valentinval90/Poolconnect/circuit_image.png

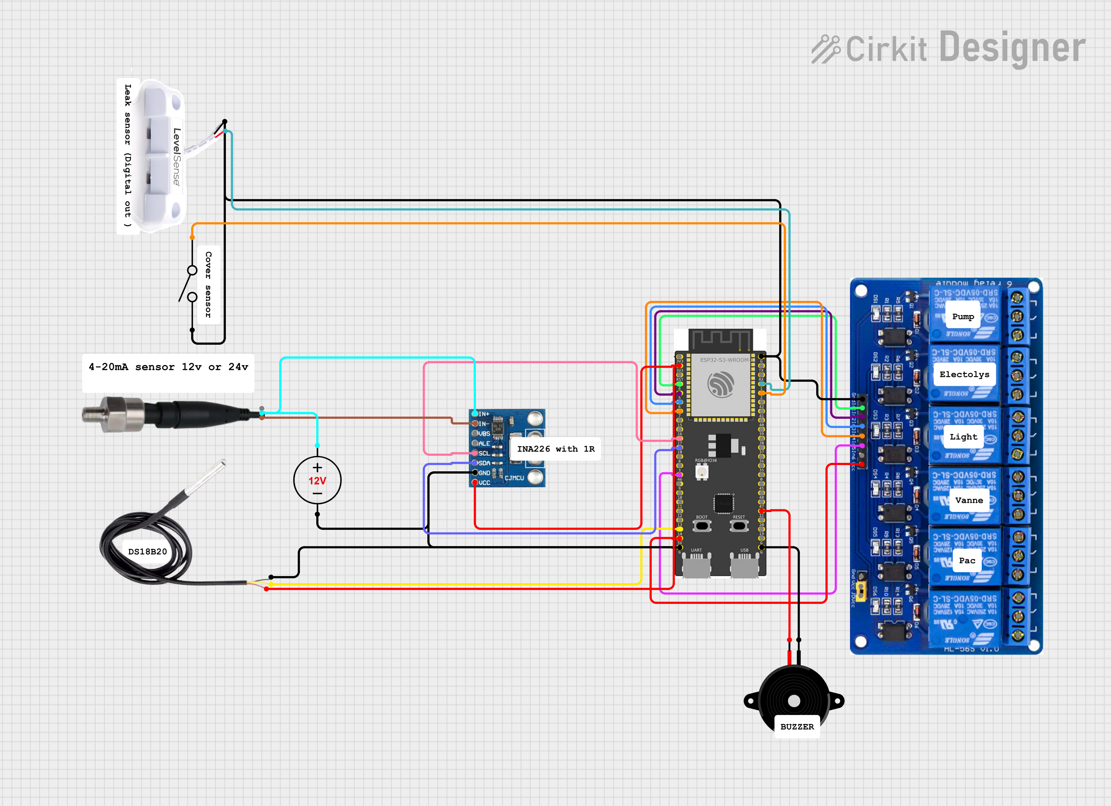
circuit_image.png
