valentinval90/Poolconnect/img/Assistant_Etalonnage.png

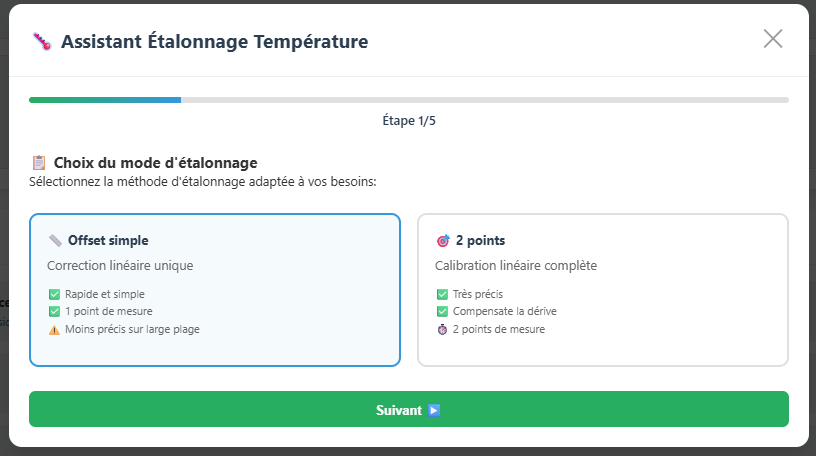
img/Assistant_Etalonnage.png
