valentinval90/Poolconnect/img/Assistant_Etalonnage_valid.png

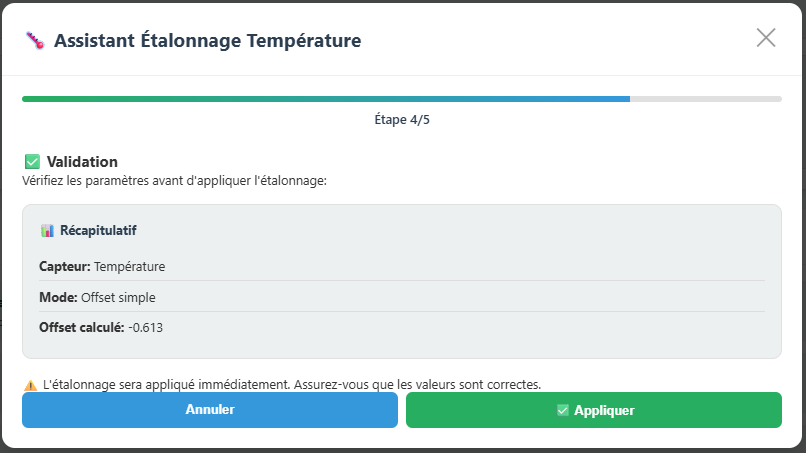
img/Assistant_Etalonnage_valid.png
