valentinval90/Poolconnect/img/Controle.png

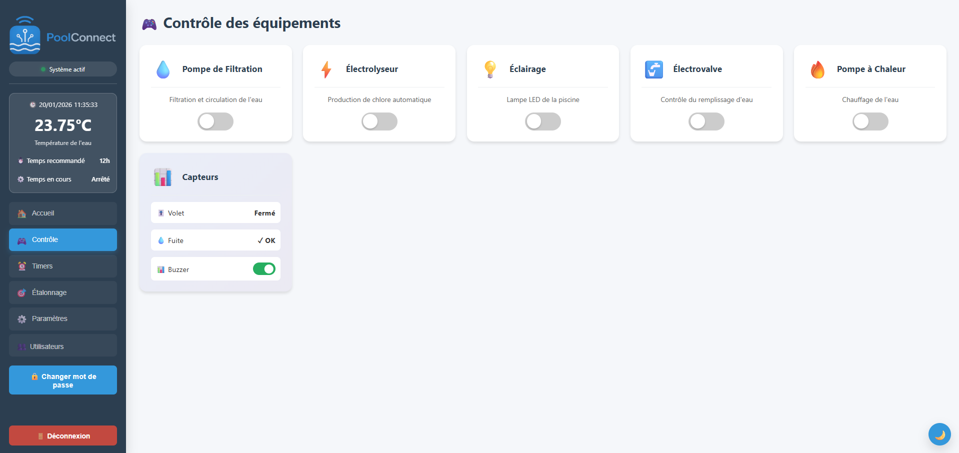
img/Controle.png
