valentinval90/Poolconnect/img/Etalonnage.png

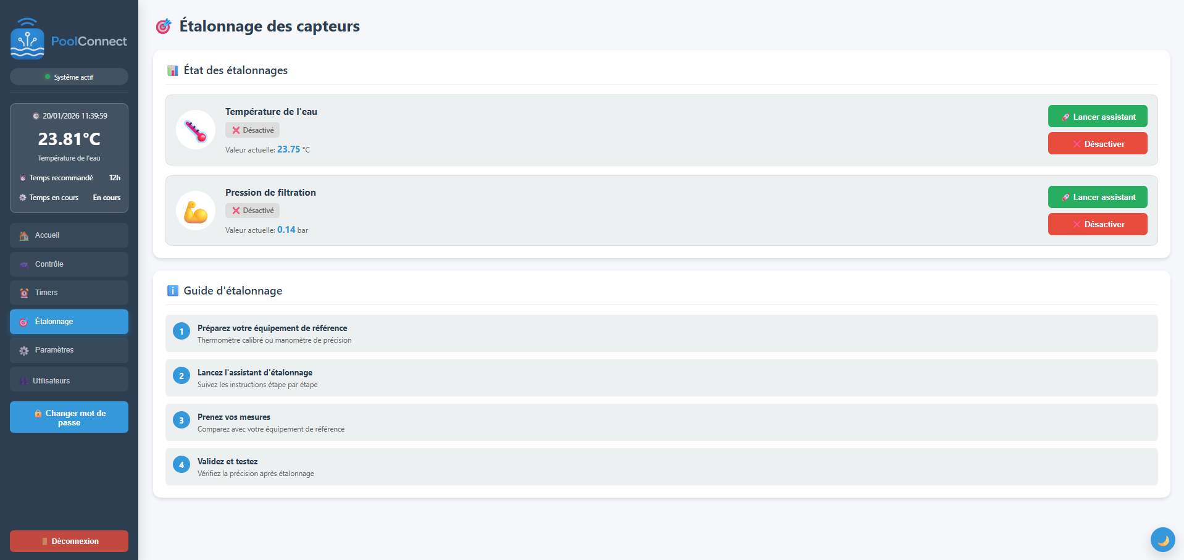
img/Etalonnage.png
