valentinval90/Poolconnect/img/Nouveau_timmer_action.png

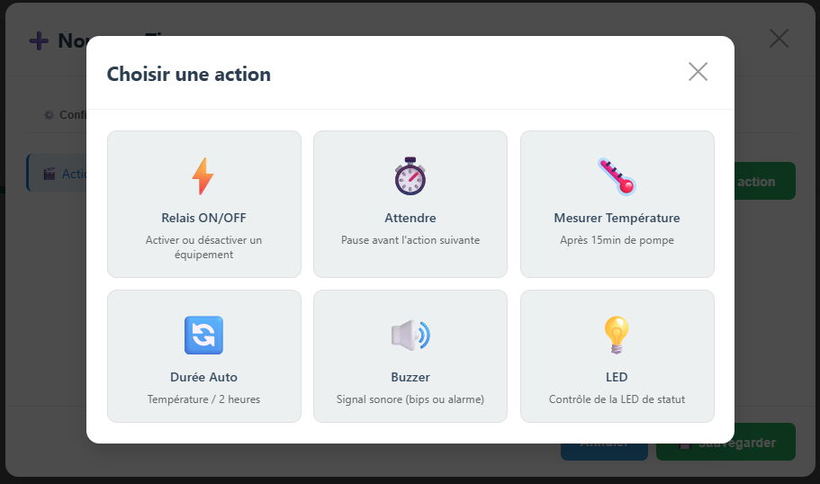
img/Nouveau_timmer_action.png
