valentinval90/Poolconnect/img/Nouveau_timmer_Aperçus.png

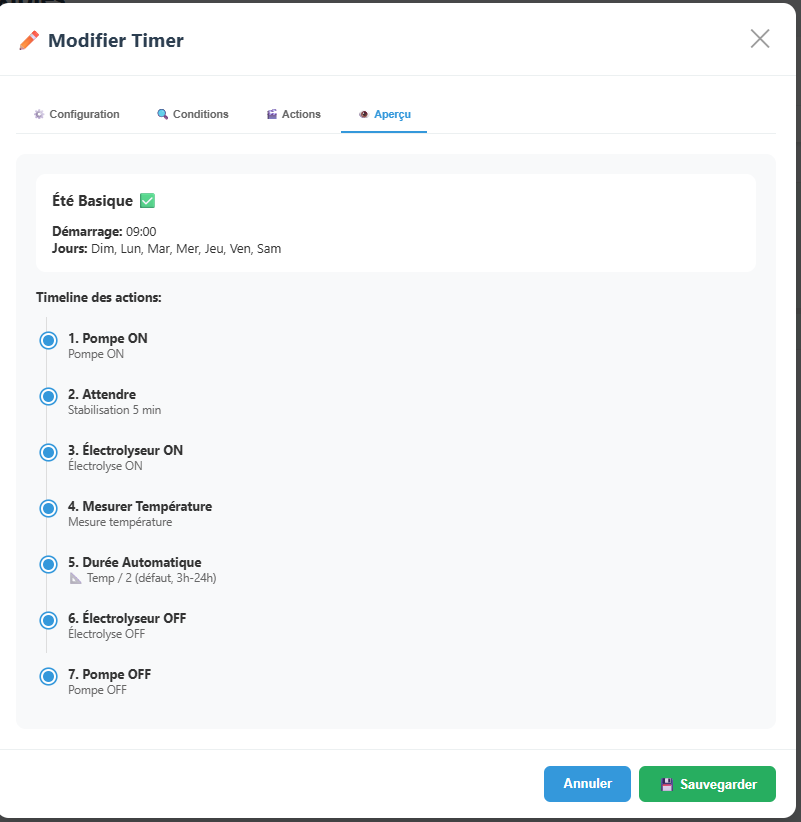
img/Nouveau_timmer_Aperçus.png
