valentinval90/Poolconnect/img/Nouveau_timmer_Condition.png

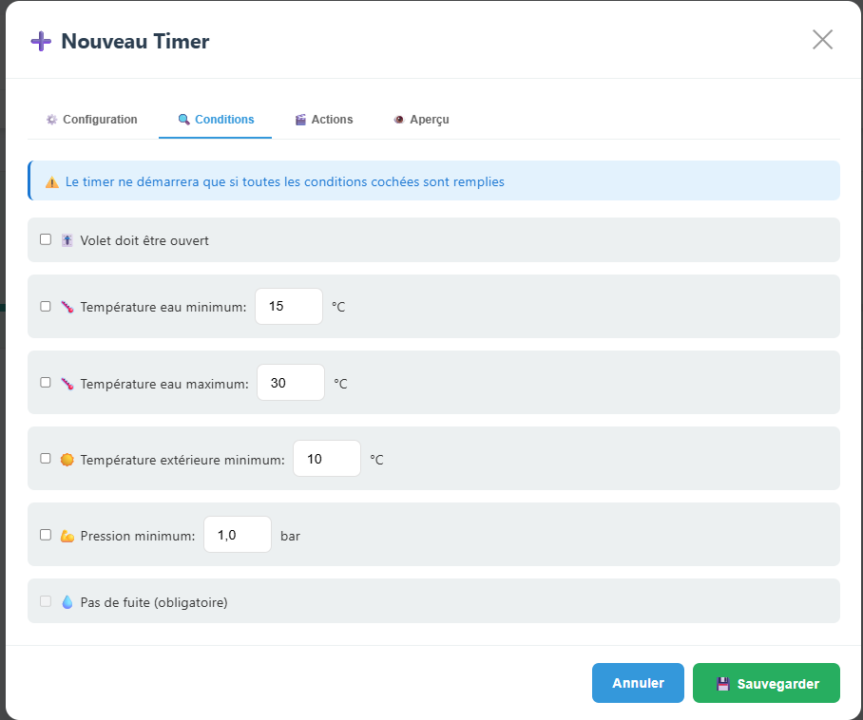
img/Nouveau_timmer_Condition.png
