valentinval90/Poolconnect/img/Nouveau_timmer_config.png

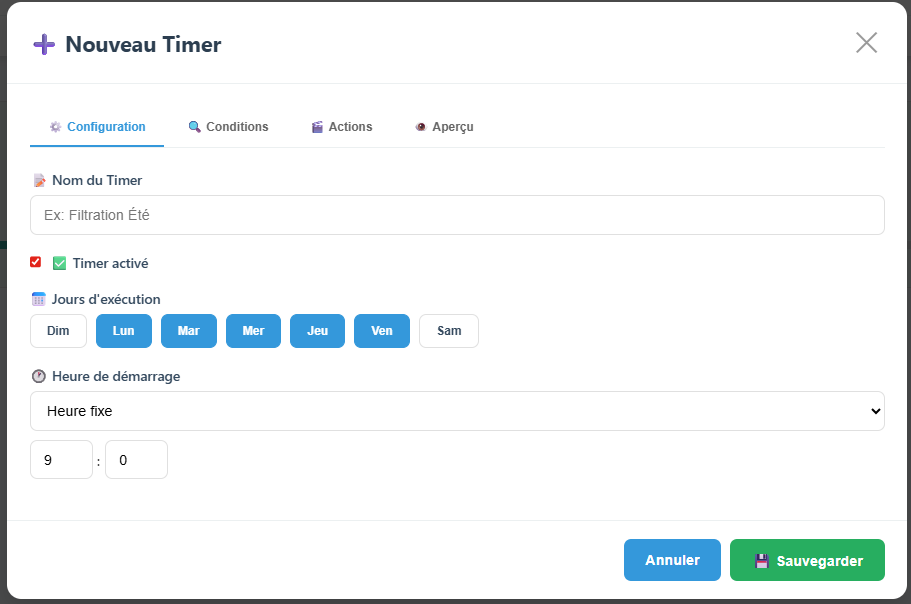
img/Nouveau_timmer_config.png
