valentinval90/Poolconnect/img/Parametres_BAS.png

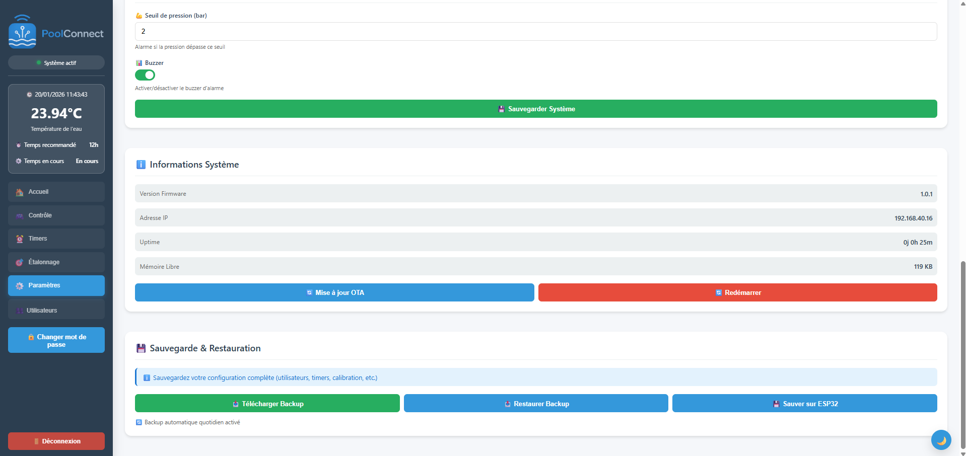
img/Parametres_BAS.png
