valentinval90/Poolconnect/img/Parametres_HAUT.png

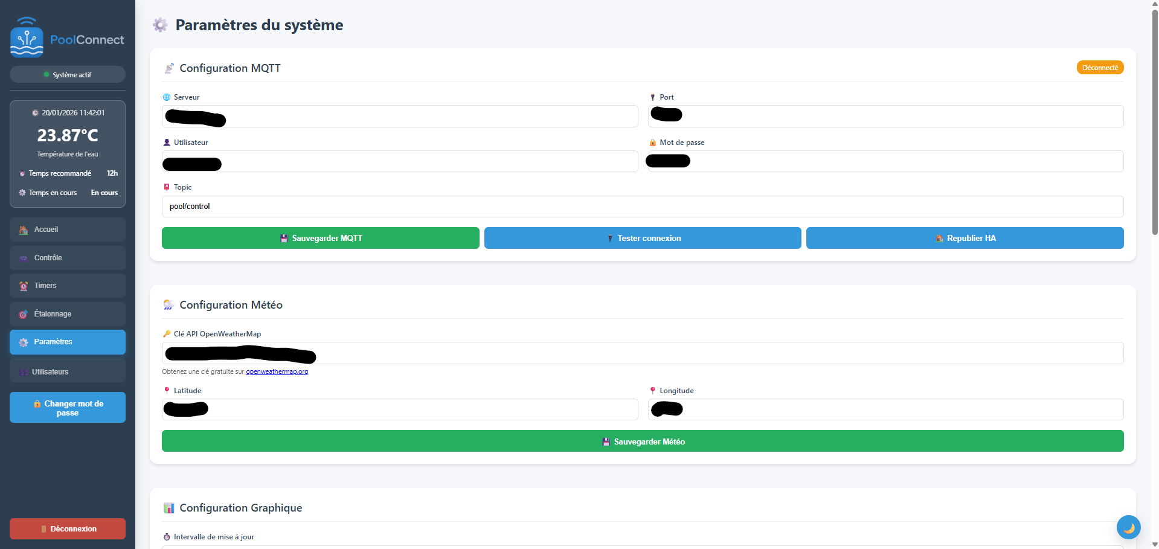
img/Parametres_HAUT.png
