valentinval90/Poolconnect/img/Parametres_MIDL.png

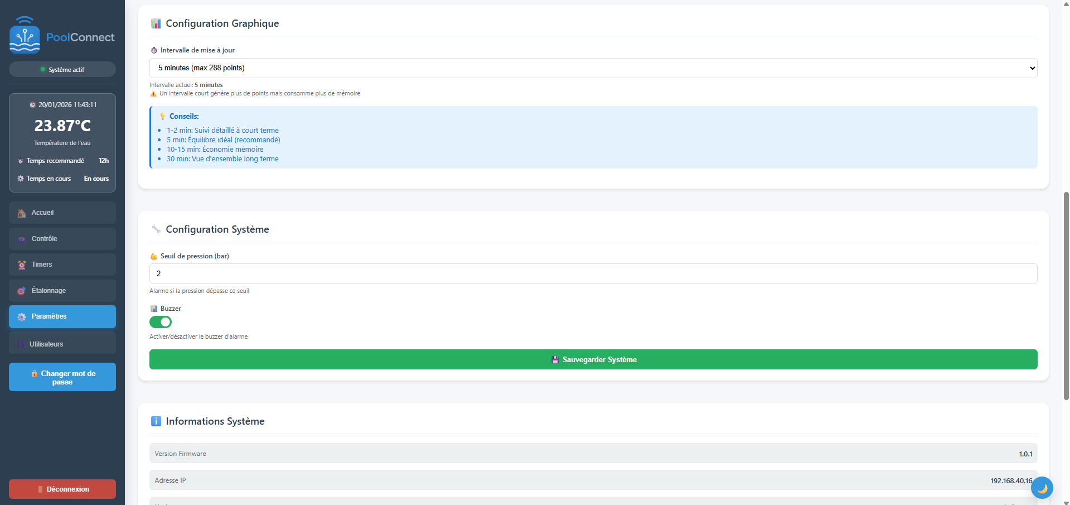
img/Parametres_MIDL.png
