valentinval90/Poolconnect/img/Scénarios_pré_config.png

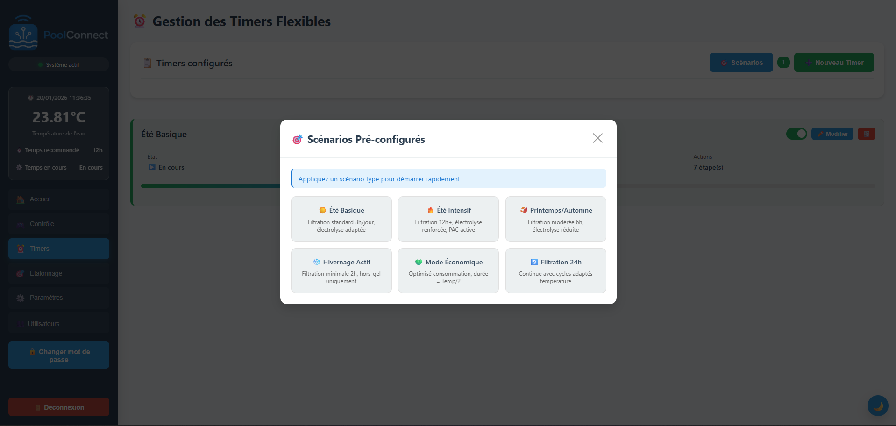
img/Scénarios_pré_config.png
