valentinval90/Poolconnect/img/TDB_BAS.png

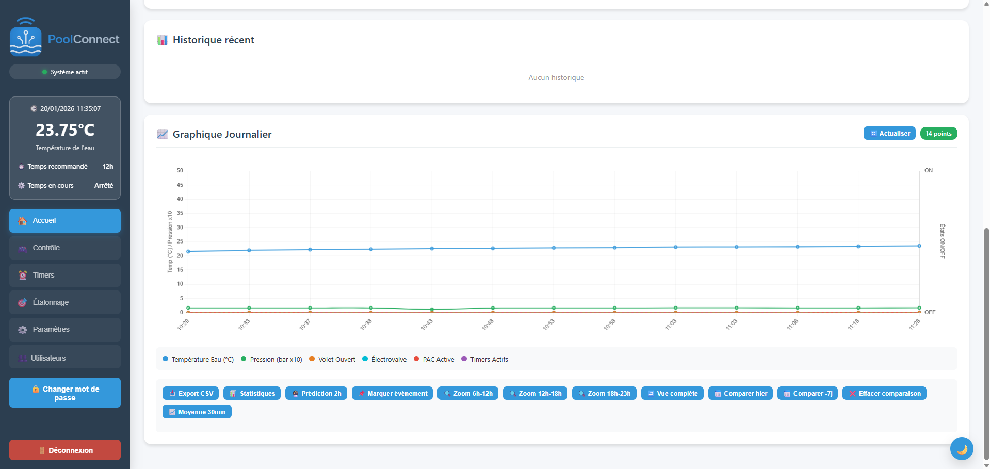
img/TDB_BAS.png
