valentinval90/Poolconnect/img/TDB_HAUT.png

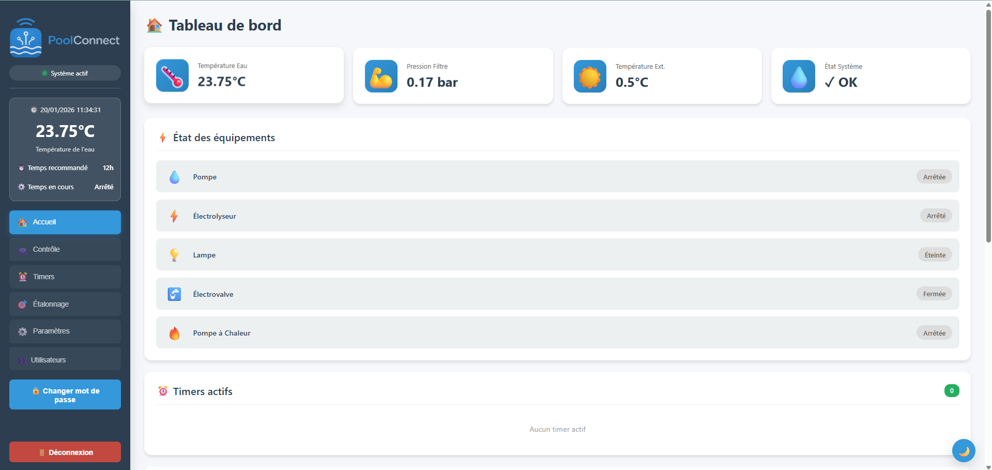
img/TDB_HAUT.png
