valentinval90/Poolconnect/img/Timers.png

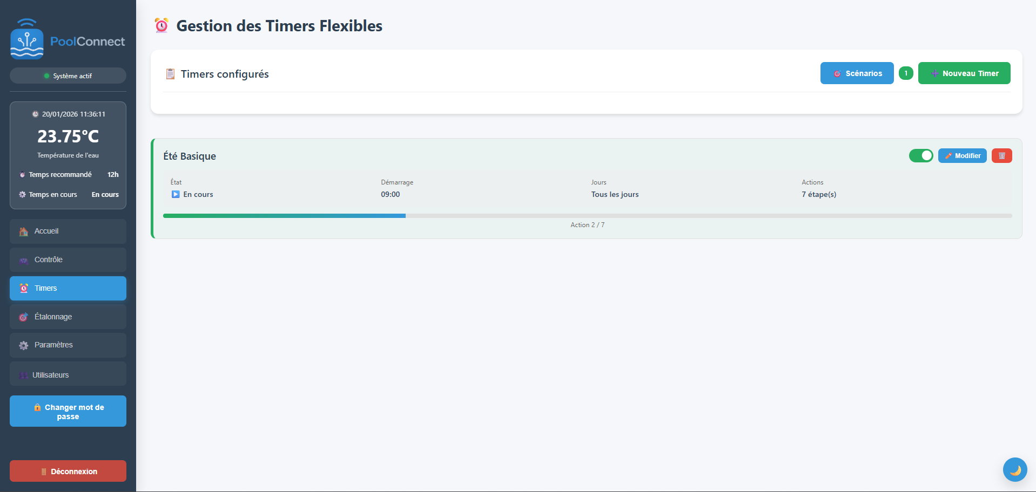
img/Timers.png
