valentinval90/Poolconnect/img/Utilisateurs.png

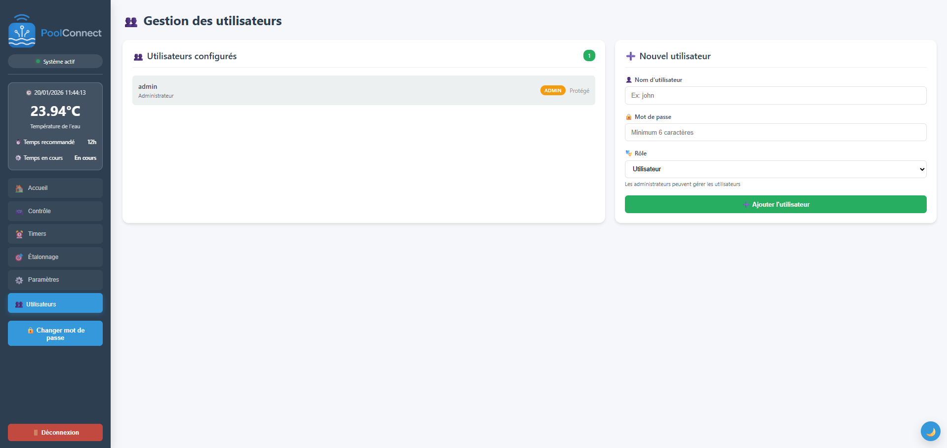
img/Utilisateurs.png
