valentinval90/Poolconnect/HW/BOM_Poolconnect_A.xlsx

No. | Quantity | Comment | Designator | Footprint | Value | Manufacturer Part | Manufacturer | Supplier Part | Supplier
1 | 1 | 19-217/G7C-AN1P2/3T | +3 | LED0603-RD |  | 19-217/G7C-AN1P2/3T | EVERLIGHT(亿光) | C84264 | LCSC
2 | 1 | 2.3kHz | BUZZER2 | BUZ-TH_BD12.0-P7.60-D0.6-FD |  | TMB12A05 | 华能 | C96093 | LCSC
3 | 5 | 100nF | C1,C2,C3,C404,C412 | C0603 |  | 0603B104K500NT | FH(风华) | C30926 | LCSC
4 | 2 | 10uF | C4,C15 | C0805 |  | CL21A106KAYNNNE | SAMSUNG(三星) | C15850 | LCSC
5 | 6 | 100nF | C5,C6,C7,C8,C9,C14 | C0603 |  | CC0603KRX7R9BB104 | YAGEO(国巨) | C14663 | LCSC
6 | 2 | 22uF | C10,C13 | C0603 |  | CL10A226MO7JZNC | SAMSUNG(三星) | C2762594 | LCSC
7 | 1 | 1uF | C16 | C0603 |  | C1608X5R1C105KT000N | TDK | C76611 | LCSC
8 | 2 | 10uF | C17,C19 | C0603 |  | 0603F106M160NT | FH | C48906 | LCSC
9 | 1 | 100nF | C18 | C1206 |  | GCM31C5C1H104FA16L | muRata(村田) | C1864297 | LCSC
10 | 1 | DB125-3.81-3P-RD | CN1 | CONN-TH_3P-P3.81_L7.4-W11.4 |  | DB125-3.81-3P-RD-S | DORABO(地博电气) | C2858301 | LCSC
11 | 1 | Led_Electrovane | CN7 | CONN-TH_2P-P3.81_DB2EVC-3.81-2P-BK |  | DB2EVC-3.81-2P-GN | DORABO(地博电气) | C395686 | LCSC
12 | 1 | Led_Lampe | CN8 | CONN-TH_2P-P3.81_DB2EVC-3.81-2P-BK |  | DB2EVC-3.81-2P-GN | DORABO(地博电气) | C395686 | LCSC
13 | 1 | Led_Pump | CN9 | CONN-TH_2P-P3.81_DB2EVC-3.81-2P-BK |  | DB2EVC-3.81-2P-GN | DORABO(地博电气) | C395686 | LCSC
14 | 1 | Led_Electrolyseur | CN10 | CONN-TH_2P-P3.81_DB2EVC-3.81-2P-BK |  | DB2EVC-3.81-2P-GN | DORABO(地博电气) | C395686 | LCSC
15 | 1 | Led_PAC | CN11 | CONN-TH_2P-P3.81_DB2EVC-3.81-2P-BK |  | DB2EVC-3.81-2P-GN | DORABO(地博电气) | C395686 | LCSC
16 | 1 | Manuel_PAC | CN12 | CONN-TH_3P-P3.81_WJ15EDGVC-3.81-3P |  | WJ15EDGVC-3.81-3P | KANGNEX(康奈克斯电气) | C8389 | LCSC
17 | 1 | Manuel_Elecrovane | CN13 | CONN-TH_3P-P3.81_WJ15EDGVC-3.81-3P |  | WJ15EDGVC-3.81-3P | KANGNEX(康奈克斯电气) | C8389 | LCSC
18 | 1 | Manuel_Lampe | CN14 | CONN-TH_3P-P3.81_WJ15EDGVC-3.81-3P |  | WJ15EDGVC-3.81-3P | KANGNEX(康奈克斯电气) | C8389 | LCSC
19 | 1 | Manuel_Pump | CN15 | CONN-TH_3P-P3.81_WJ15EDGVC-3.81-3P |  | WJ15EDGVC-3.81-3P | KANGNEX(康奈克斯电气) | C8389 | LCSC
20 | 1 | Manuel_Electrolyseur | CN16 | CONN-TH_3P-P3.81_WJ15EDGVC-3.81-3P |  | WJ15EDGVC-3.81-3P | KANGNEX(康奈克斯电气) | C8389 | LCSC
21 | 5 | 1N4148 | D1,D3,D4,D5,D807 | SOD-123_L2.8-W1.8-LS3.7-RD |  | 1N4148W | YFW(佑风微) | C1884539 | LCSC
22 | 1 | 1N5819HW-7-F | D2 | SOD-123_L2.8-W1.8-LS3.7-FD |  | 1N5819HW-7-F | DIODES(美台) | C82544 | LCSC
23 | 3 | LESD5D5.0CT1G | D9,D10,D11 | SOD-523_L1.2-W0.8-LS1.6-BI |  | LESD5D5.0CT1G | Leshan Radio | C383211 | LCSC
24 | 5 | G2RL-1 DC5 | K1,K2,K3,K4,K5 | RELAY-TH_G2RL-1-DCXX |  | G2RL-1 DC5 | OMRON(欧姆龙) | C1524672 | LCSC
25 | 1 | 2.2uH | L1 | IND-SMD_L4.4-W4.2 |  | FXL0420-2R2-M | cjiang(长江微电) | C167206 | LCSC
26 | 1 | 4.7uH | L2 | IND-SMD_L4.4-W4.2 |  | FXL0420-4R7-M | cjiang(长江微电) | C167208 | LCSC
27 | 1 | WJ301V-5.0-2P | P1 | CONN-TH_2P-P5.00_WJ301V-5.00-2P |  | WJ301V-5.0-2P | KANGNEX(康奈克斯电气) | C8475 | LCSC
28 | 5 | FDN335N | Q1,Q3,Q4,Q7,Q807 | SOT-23-3_L2.9-W1.3-P1.90-LS2.4-BR |  | FDN335N | HUASHUO(华朔) | C845588 | LCSC
29 | 1 | MMS8050-H-TP | Q2 | SOT-23-3_L2.9-W1.3-P1.90-LS2.4-BR |  | MMS8050-H-TP | MCC(美微科) | C668971 | LCSC
30 | 2 | L8050QLT1G | Q5,Q6 | SOT-23-3_L2.9-W1.3-P1.90-LS2.4-BR |  | L8050QLT1G | LRC(乐山无线电) | C49581 | LCSC
31 | 8 | 1MΩ | R1,R3,R5,R7,R15,R17,R32,R814 | R0603 |  | AS03W4J0105T5E | UNI-ROYAL(厚声) | C22935 | LCSC
32 | 1 | 73.2kΩ | R2 | R0603 |  | 0603WAF7322T5E | UNI-ROYAL(厚声) | C14890 | LCSC
33 | 10 | 100Ω | R4,R8,R9,R10,R11,R12,R13,R14,R24,R31 | R0603 |  | RC0603FR-07100RL | YAGEO(国巨) | C105588 | LCSC
34 | 1 | 100kΩ | R6 | R0603 |  | RC0603FR-07100KL | YAGEO(国巨) | C14675 | LCSC
35 | 4 | 10kΩ | R16,R22,R23,R30 | R0603 |  | RC0603FR-0710KL | YAGEO(国巨) | C98220 | LCSC
36 | 1 | 4.7kΩ | R18 | R0603 |  | RC0603FR-074K7L | YAGEO(国巨) | C99782 | LCSC
37 | 1 | 10Ω | R19 | R2512 |  | RT2512BKD0710RL | YAGEO(国巨) | C4038810 | LCSC
38 | 2 | 47Ω | R20,R21 | R0603 |  | RT0603BRB0747RL | YAGEO(国巨) | C860409 | LCSC
39 | 4 | 0kΩ | R25,R26,R27,R33 | R0603 |  | RN73H1JTTD1001B25 | KOA | C186186 | LCSC
40 | 3 | 10kΩ | R28,R29,R34 | R0603 |  | CR-03JA7---10K | Viking(光颉) | C465463 | LCSC
41 | 1 | 1kΩ | R35 | R0603 |  | RN73H1JTTD1001B25 | KOA | C186186 | LCSC
42 | 1 | 47.5kΩ | R36 | R0603 |  | ERJPB3B4752V | PANASONIC(松下) | C413699 | LCSC
43 | 1 | 22.1Ω | R37 | R0603 |  | RCT0322R1FLF | HKR | C177566 | LCSC
44 | 2 | 5.1kΩ | R40,R41 | R0603 |  | RTT035101BTP | RALEC(旺诠) | C312257 | LCSC
45 | 1 | 360Ω | R103 | R0603 |  | 0603WAF3600T5E | UNI-ROYAL(厚声) | C25194 | LCSC
46 | 1 | 100K | R405 | R0603 |  | RC0603FR-07100KL | YAGEO(国巨) | C14675 | LCSC
47 | 1 | RESET | SW1 | KEY-SMD_B3U-1000PM |  | B3U-1000P | OMRON(欧姆龙) | C231329 | LCSC
48 | 1 | B3U-1000P | SW2 | KEY-SMD_B3U-1000PM |  | B3U-1000P | OMRON(欧姆龙) | C231329 | LCSC
49 | 1 | TPS54395PWPR | U1 | HTSSOP-16_L5.0-W4.4-P0.65-LS6.4-BL-EP3.0 |  | TPS54395PWPR | TI(德州仪器) | C2867310 | LCSC
50 | 2 | 22.1kΩ | U2,U10 | R0603 |  | FRC0603F2212TS | FOJAN(富捷) | C2960862 | LCSC
51 | 1 | ESP32-S3-WROOM-1(N16R8) | U3 | WIRELM-SMD_ESP32-S3-WROOM-1 |  | ESP32-S3-WROOM-1-N16R8 | ESPRESSIF(乐鑫) | C2913202 | LCSC
52 | 1 | 124kΩ | U4 | R0603 |  | FRC0603F1243TS | FOJAN(富捷) | C2933136 | LCSC
53 | 1 | SN74LVC1G08DBVR | U5 | SOT-23-5_L3.0-W1.7-P0.95-LS2.8-BR |  | SN74LVC1G08DBVR | TI(德州仪器) | C7666 | LCSC
54 | 1 | Capteur volet | U6 | CONN-TH_2P-P5.08_DB128L-5.08-2P |  | DB128L-5.08-2P-GN-S | DORABO(地博电气) | C395868 | LCSC
55 | 1 | MAX6816EUS+T | U7 | SOT-143_L2.9-W1.3-P1.92-LS2.3-BR |  | MAX6816EUS+T | ADI(亚德诺)/MAXIM(美信) | C41637 | LCSC
56 | 1 | LM393DR | U9 | SOIC-8_L5.0-W4.0-P1.27-LS6.0-BL |  | LM393DR | TI(德州仪器) | C67470 | LCSC
57 | 1 | PAC | U11 | CONN-TH_2P-P5.08_DB128L-5.08-2P |  | DB128L-5.08-2P-GN-S | DORABO(地博电气) | C395868 | LCSC
58 | 1 | Pump | U15 | CONN-TH_2P-P5.08_DB128L-5.08-2P |  | DB128L-5.08-2P-GN-S | DORABO(地博电气) | C395868 | LCSC
59 | 1 | Electrovane | U18 | CONN-TH_2P-P5.08_DB128L-5.08-2P |  | DB128L-5.08-2P-GN-S | DORABO(地博电气) | C395868 | LCSC
60 | 1 | Lampe | U19 | CONN-TH_2P-P5.08_DB128L-5.08-2P |  | DB128L-5.08-2P-GN-S | DORABO(地博电气) | C395868 | LCSC
61 | 1 | 1N4007W1 | U20 | SOD-123FL_L2.7-W1.8-LS3.7-RD |  | 1N4007W | MSKSEMI(美森科) | C7528871 | LCSC
62 | 1 | INA226AIDGSR | U21 | MSOP-10_L3.0-W3.0-P0.50-LS5.0-BL |  | INA226AIDGSR | TI(德州仪器) | C49851 | LCSC
63 | 1 | Capteur fuite | U24 | CONN-TH_2P-P5.08_DB128L-5.08-2P |  | DB128L-5.08-2P-GN-S | DORABO(地博电气) | C395868 | LCSC
64 | 1 | TDO | U25 | PADPAD
65 | 1 | TCK | U26 | PADPAD
66 | 1 | TDI | U27 | PADPAD
67 | 1 | TMS | U28 | PADPAD
68 | 1 | D+ | U29 | PADPAD
69 | 1 | D- | U30 | PADPAD
70 | 1 | Electrolyseur | U31 | CONN-TH_2P-P5.08_DB128L-5.08-2P |  | DB128L-5.08-2P-GN-S | DORABO(地博电气) | C395868 | LCSC
71 | 1 | SK6812MINI-HS | U32 | LED-SMD_4P-L3.5-W3.5-BR_SK6812MINI-HS |  | SK6812MINI-HS | null | C2922787 | LCSC
72 | 1 | CP2102N-A02-GQFN28R | U34 | QFN-28_L5.0-W5.0-P0.50-TL-EP3.3 |  | CP2102N-A02-GQFN28R | SILICON LABS(芯科) | C964632 | LCSC
73 | 1 | Capteur pression | U37 | CONN-TH_2P-P5.08_DB128L-5.08-2P |  | DB128L-5.08-2P-GN-S | DORABO(地博电气) | C395868 | LCSC
74 | 1 | TYPE-C-31-D-09_C7463258 | USB1 | USB-C-TH_TYPE-C-31-D-09 |  | TYPE-C-31-D-09 | 韩国韩荣 | C7463258 | LCSC
75 | 1 | 10kΩ | VR1 | RES-ADJ-TH_3362P |  | 3362P-1-103LF | BOURNS | C58159 | LCSC
