valentinval90/Poolconnect/img/Assistant_Etalonnage_step2.png

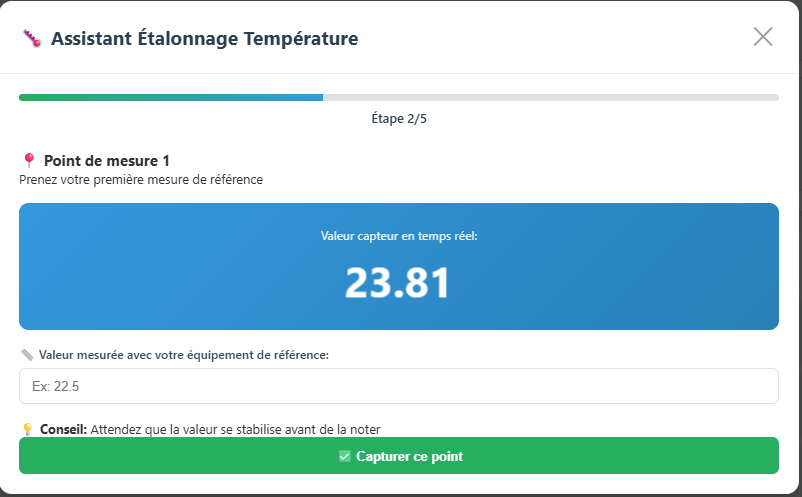
img/Assistant_Etalonnage_step2.png
