valentinval90/Poolconnect/HW/SCH_Poolconnect_REV1.pdf

# GND ALERT

### DS18B20

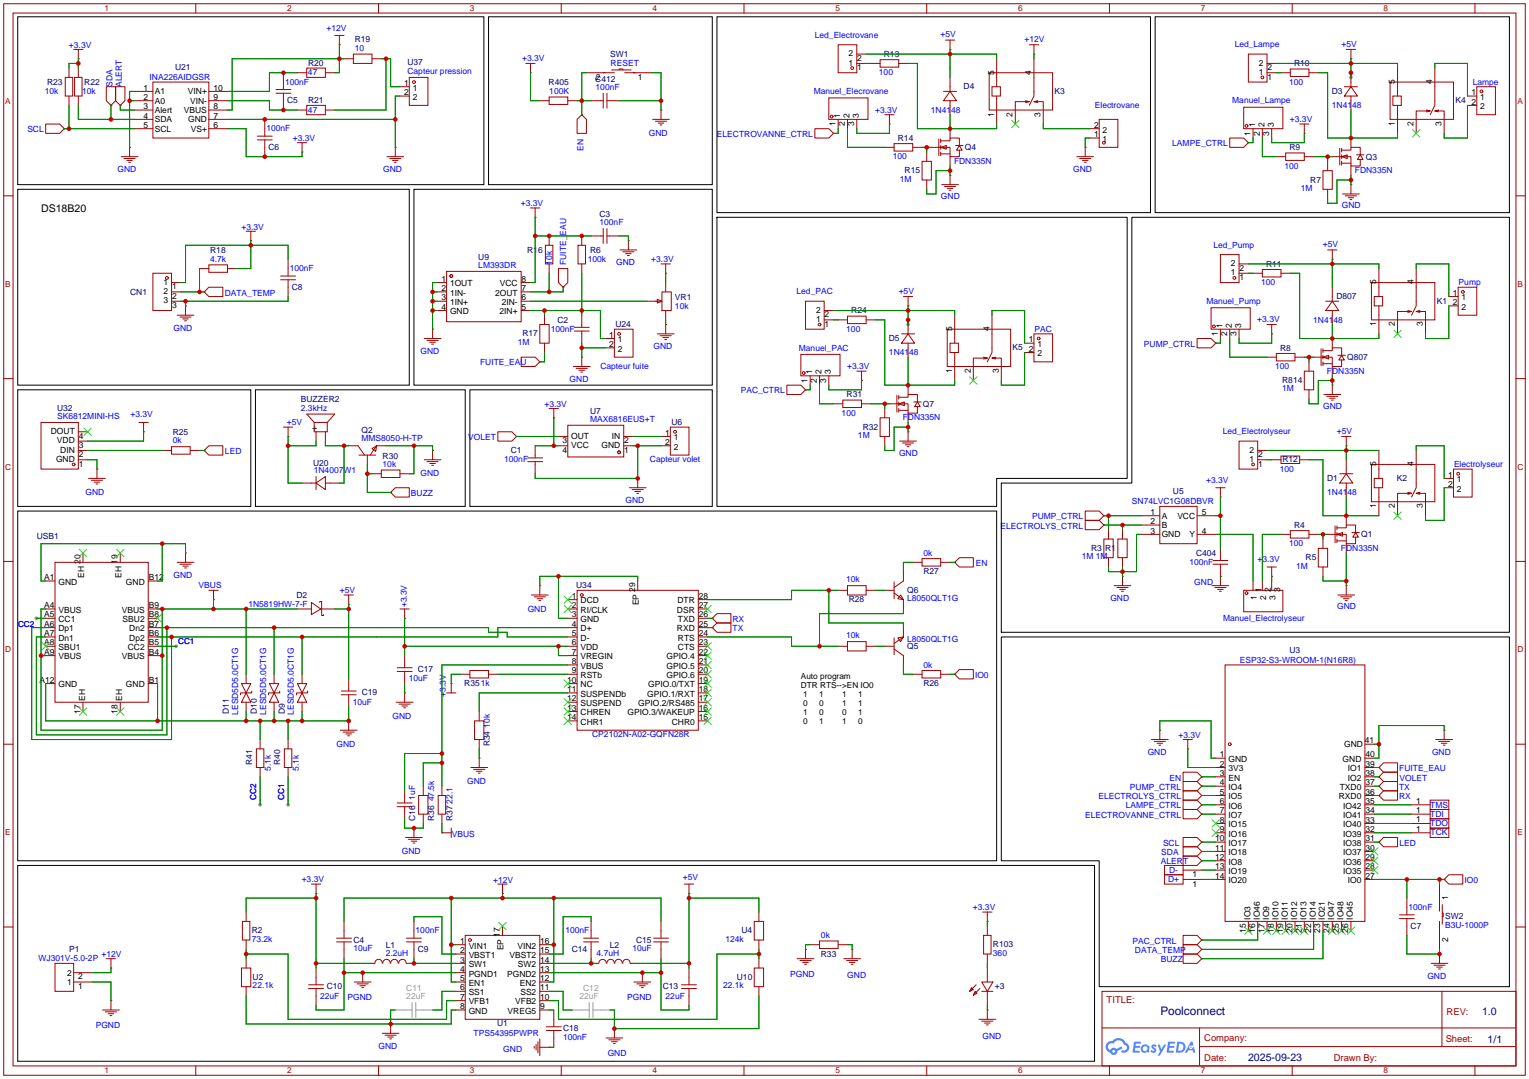
[picture p19: page 1]
