valentinval90/Poolconnect/HW/PCB_VIEW.pdf

R30R31

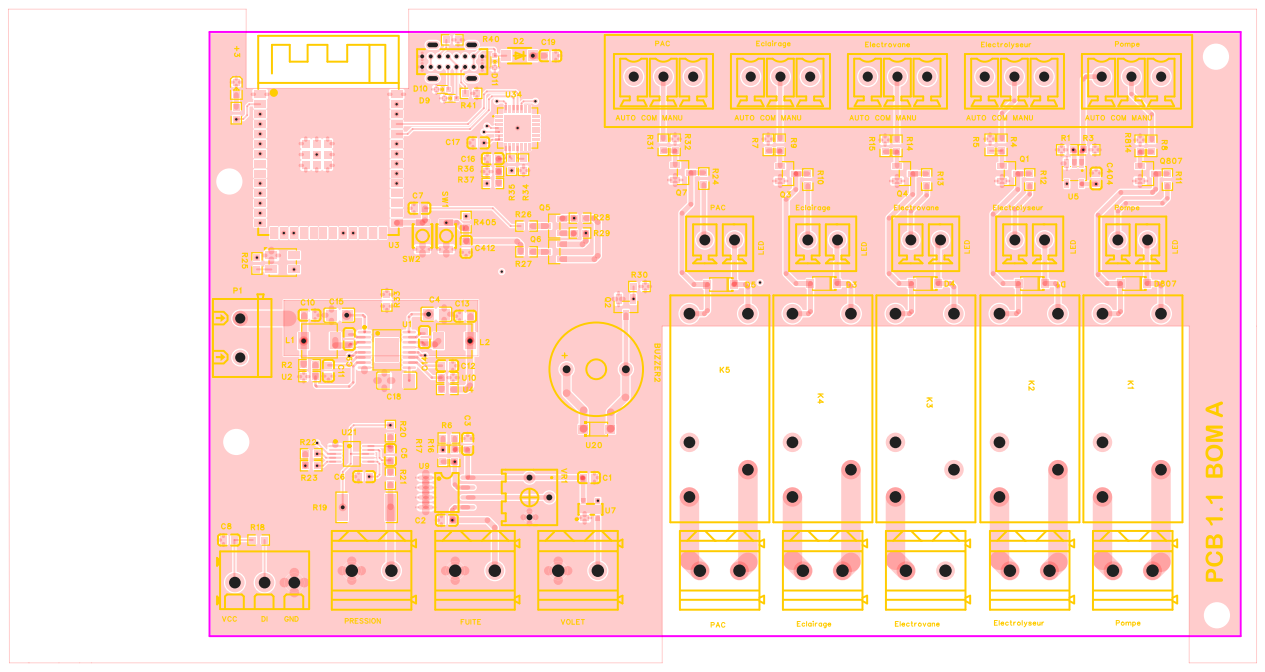
[picture p20: page 1]

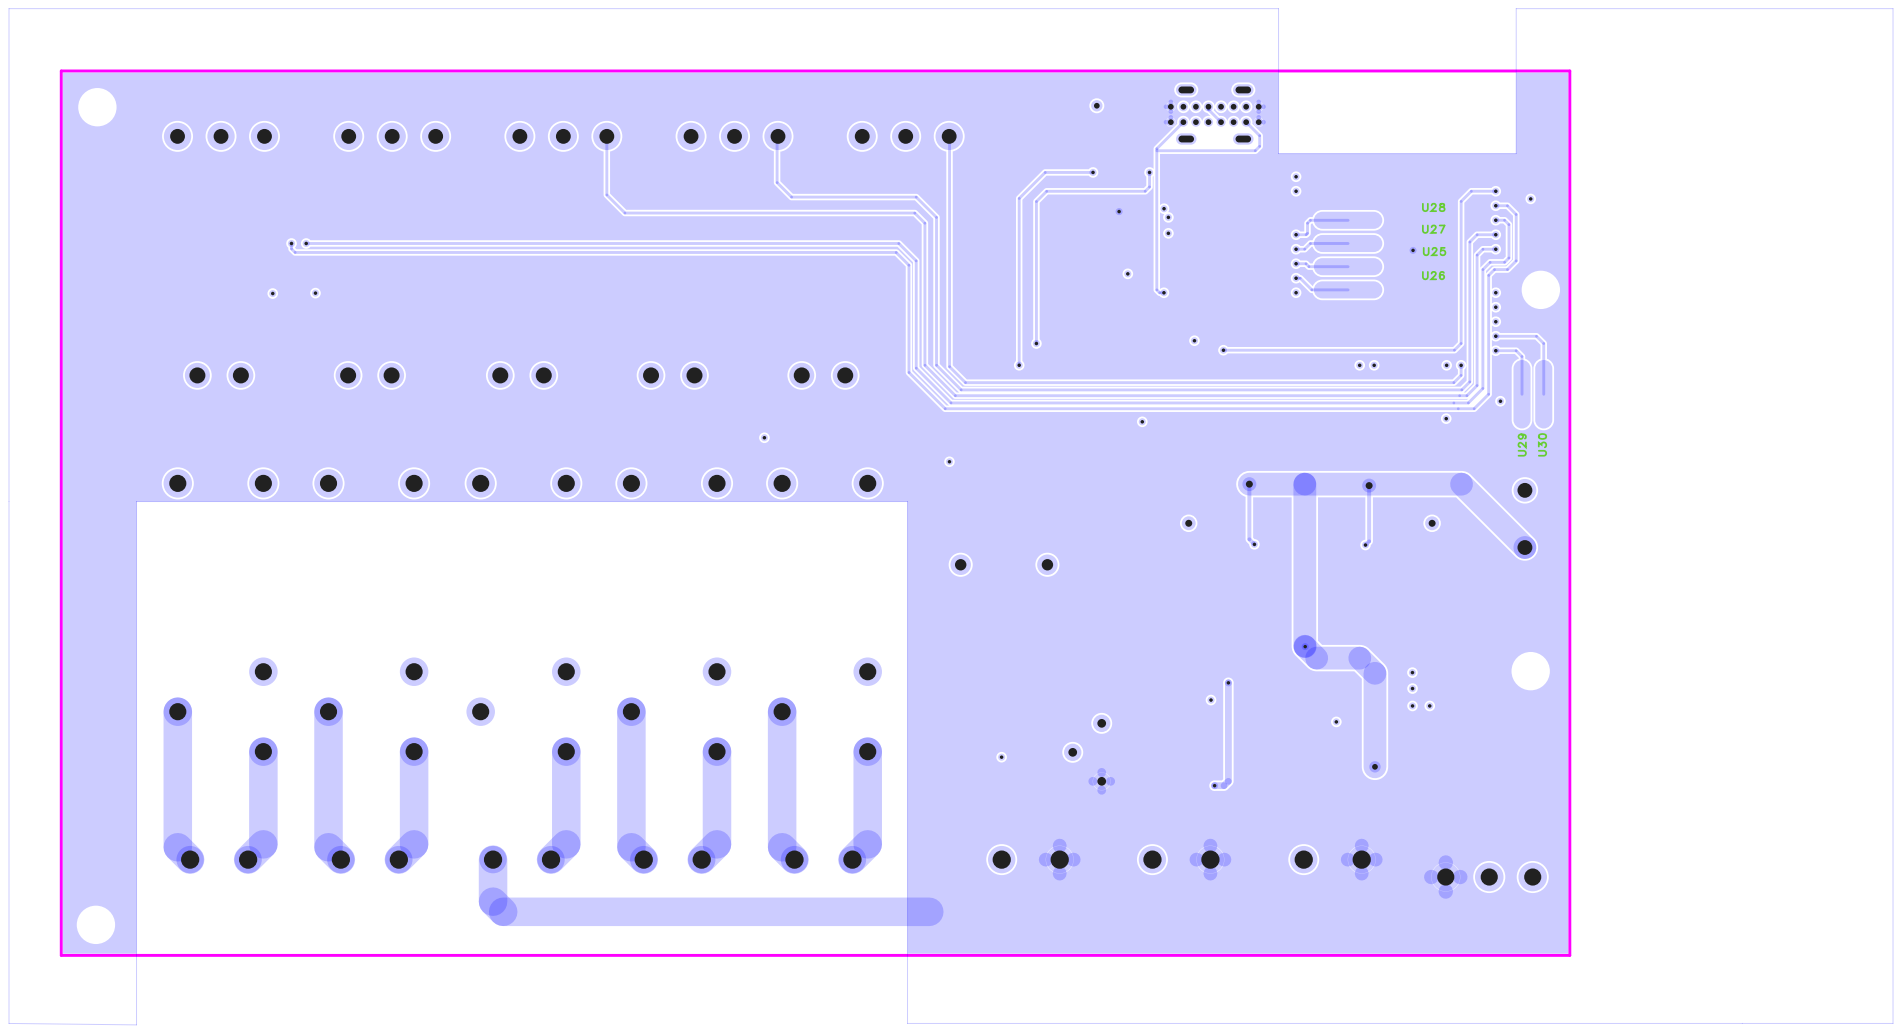
[picture p21: page 2]

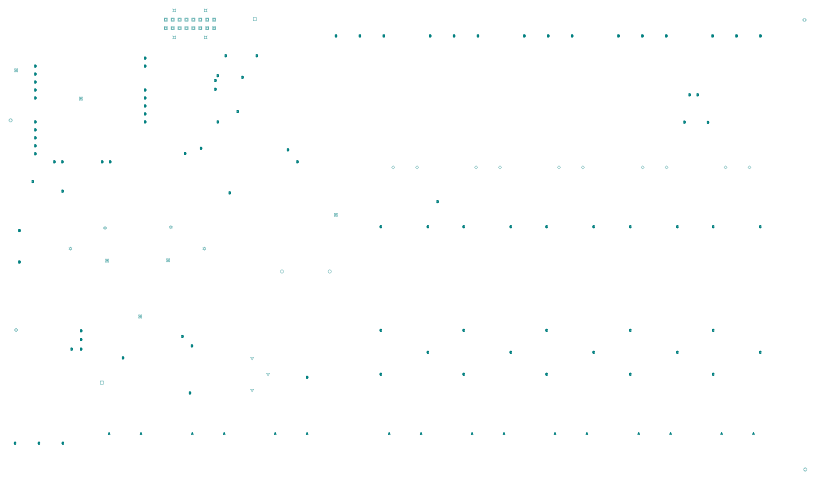
[picture p22: page 3]

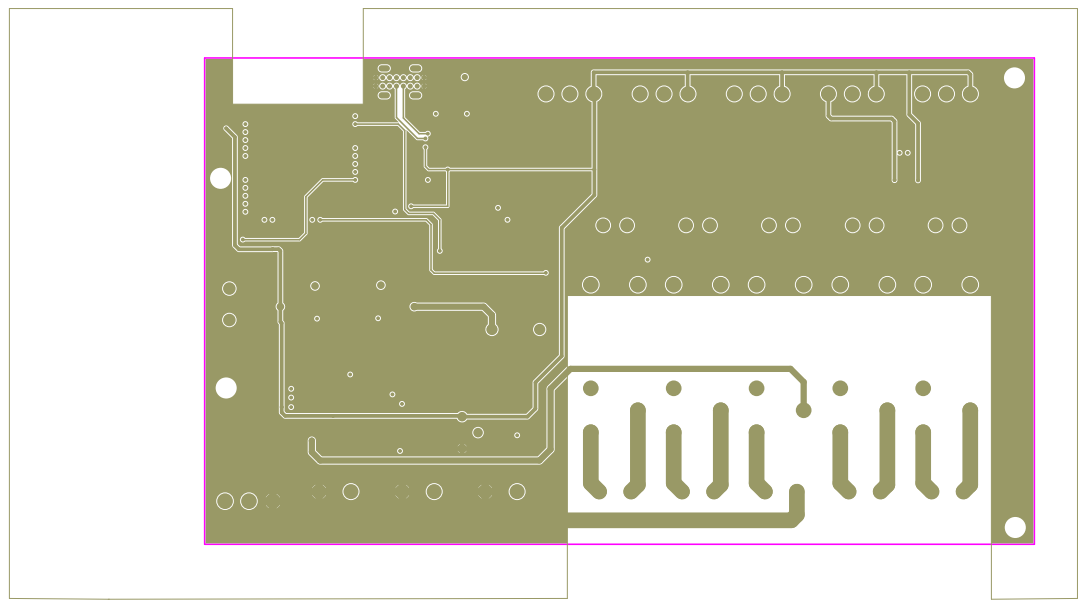
[picture p23: page 4]

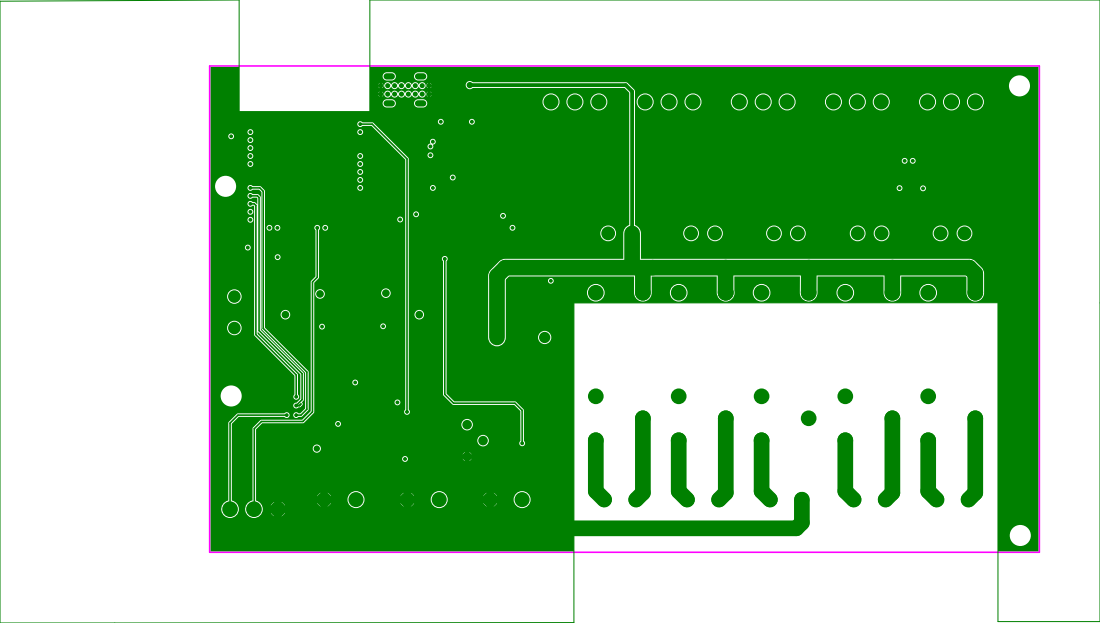
[picture p24: page 5]
