valentinval90/Poolconnect/(commit log)

2026-01-20 FW1.0.1
    First FW
    [partitions.csv]
2026-01-21 README_FR
    Ajout de nouveaux points sur les limitations des installations de piscines traditionnelles.
2026-02-03 chore: ajout dossier build
    [partitions.csv]
2026-02-04 mise à jour complète du projet
    [partitions.csv]
